electroZ-microsystems/SL5C/README.md

# SL5C

Spot light 5 colors DMX

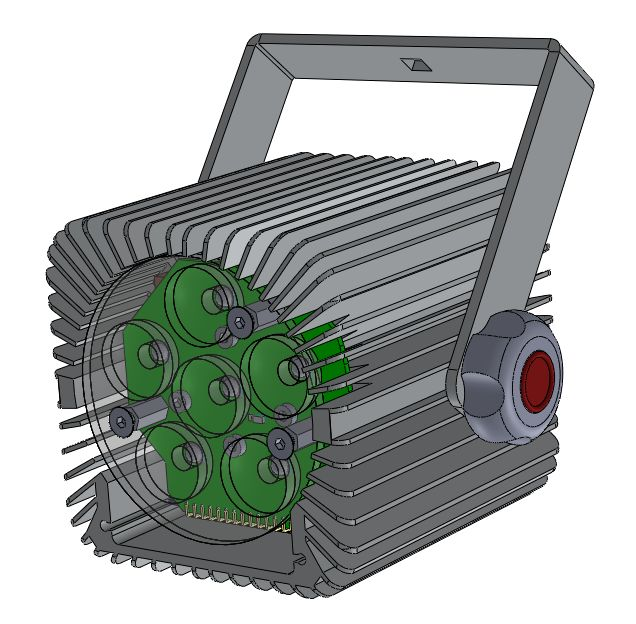
[picture p1: Image/20150911_225059_SL5CL_1.93_002..jpg]
[//]: 

<p align="center">
  SL5C
</p>

# Datasheet

Total Power 40W

Warm Wite Power 20W

Cold White Power 5W

Red Power 5W

Green Power 5W

Blue Power 5W

Voltage 24V

Number of power LEDs RGBcW 4, Warm White 2 from CREE

Crontrol DMX

# Controller 

Atmel Arduino Leonardo Chip, Arduino code
