electroZ-microsystems/SL5C/Image/20131019_220510_ProjecteurLedExtruded..jpg

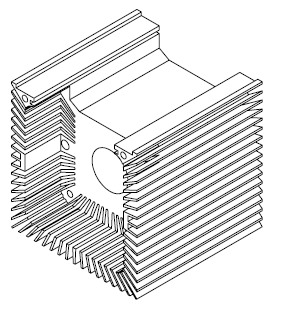
Image/20131019_220510_ProjecteurLedExtruded..jpg
