electroZ-microsystems/SL5C/Image/20140114_231739_Sim001..png

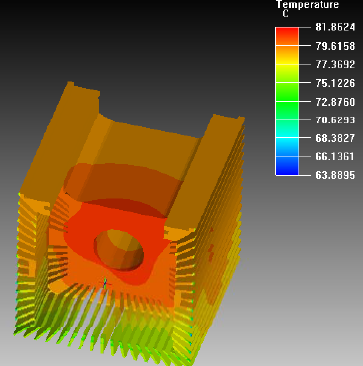
Image/20140114_231739_Sim001..png
