electroZ-microsystems/SL5C/Image/20140208_111850_XPC_Warm_Angle_med..jpg

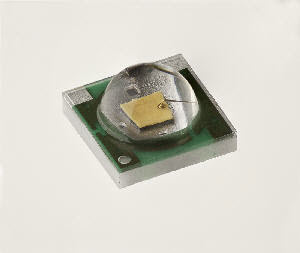
Image/20140208_111850_XPC_Warm_Angle_med..jpg
