electroZ-microsystems/SL5C/Image/20140208_112255_XPC_Warm_Angle_med..png

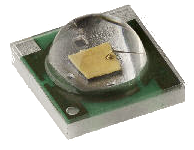
Image/20140208_112255_XPC_Warm_Angle_med..png
