electroZ-microsystems/SL5C/Image/20140509_221927_CoupeConnecteurSL5C_001..jpg

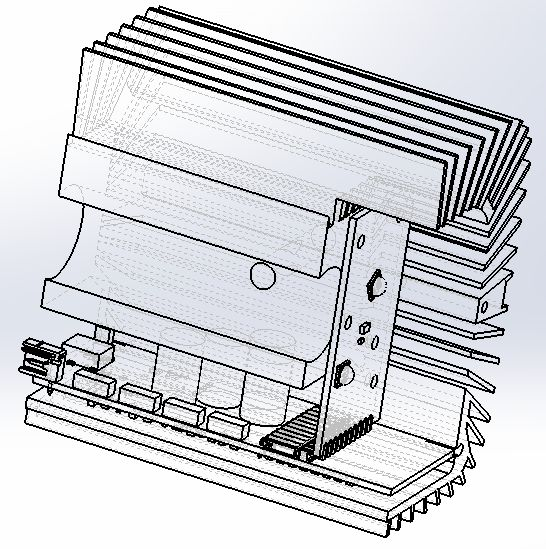
Image/20140509_221927_CoupeConnecteurSL5C_001..jpg
