electroZ-microsystems/SL5C/Image/20140509_222102_CoupeConnecteurSL5C_002..jpg

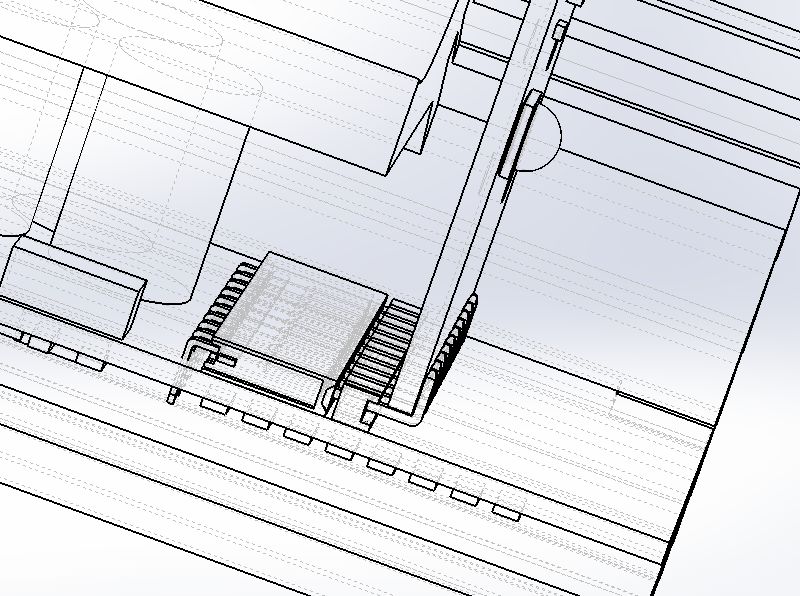
Image/20140509_222102_CoupeConnecteurSL5C_002..jpg
