electroZ-microsystems/SL5C/Image/20140916_155051_Rendu001..jpg

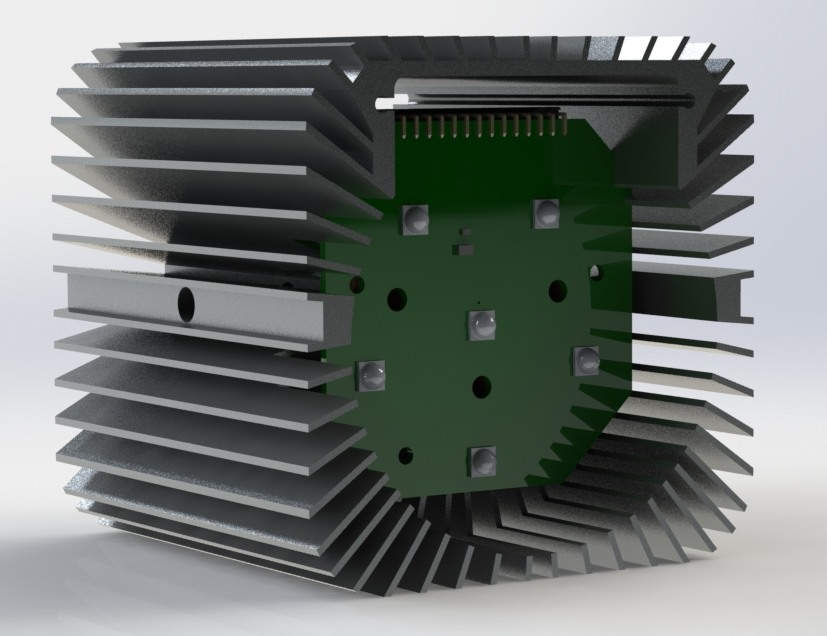
Image/20140916_155051_Rendu001..jpg
