electroZ-microsystems/SL5C/Image/20141115_224456_scan_090..jpg

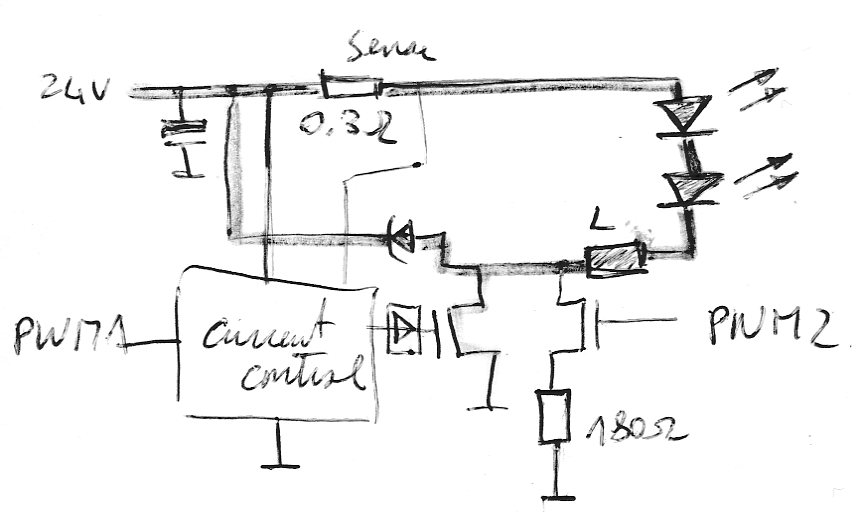
Image/20141115_224456_scan_090..jpg
