electroZ-microsystems/SL5C/Image/20150410_223701_HeatSink_1.8..jpg

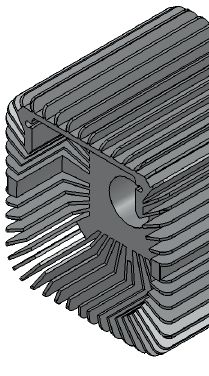
Image/20150410_223701_HeatSink_1.8..jpg
