electroZ-microsystems/SL5C/Image/20150420_132513_SpotLight_1.9_copper..jpg

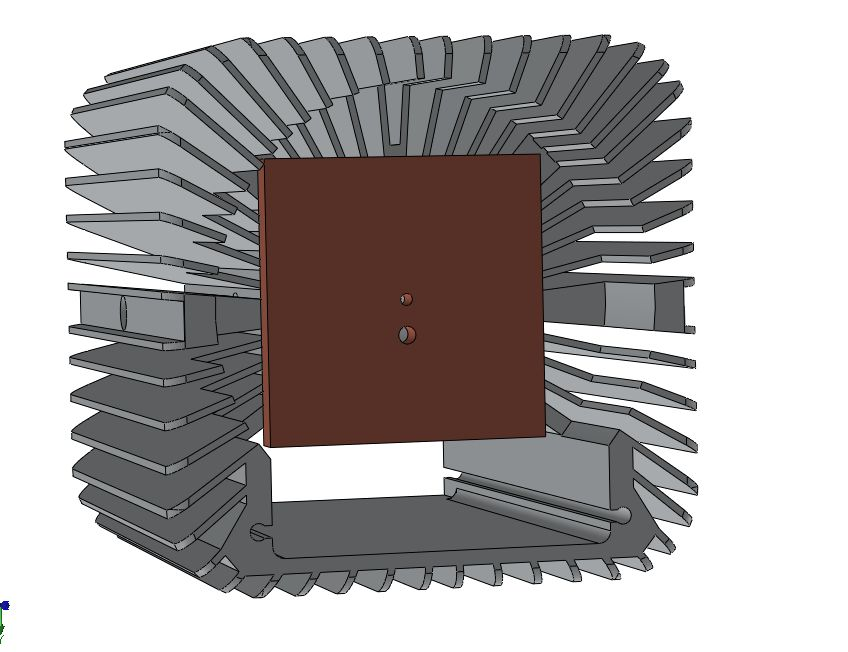
Image/20150420_132513_SpotLight_1.9_copper..jpg
