electroZ-microsystems/SL5C/Image/20150423_220920_Rendu001_version1.9..jpg

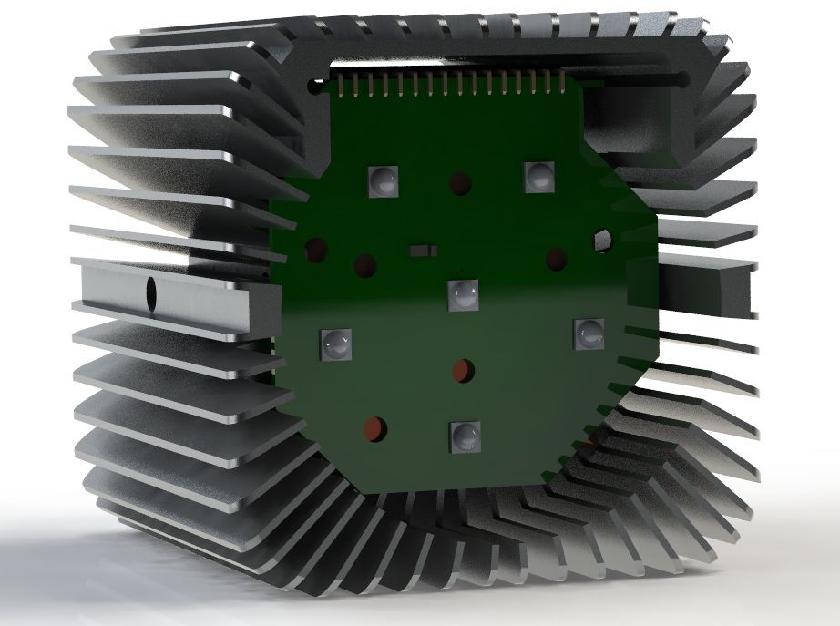
Image/20150423_220920_Rendu001_version1.9..jpg
