electroZ-microsystems/SL5C/Image/20150620_075052_HeatSink_1.92_hill_eclate..jpg

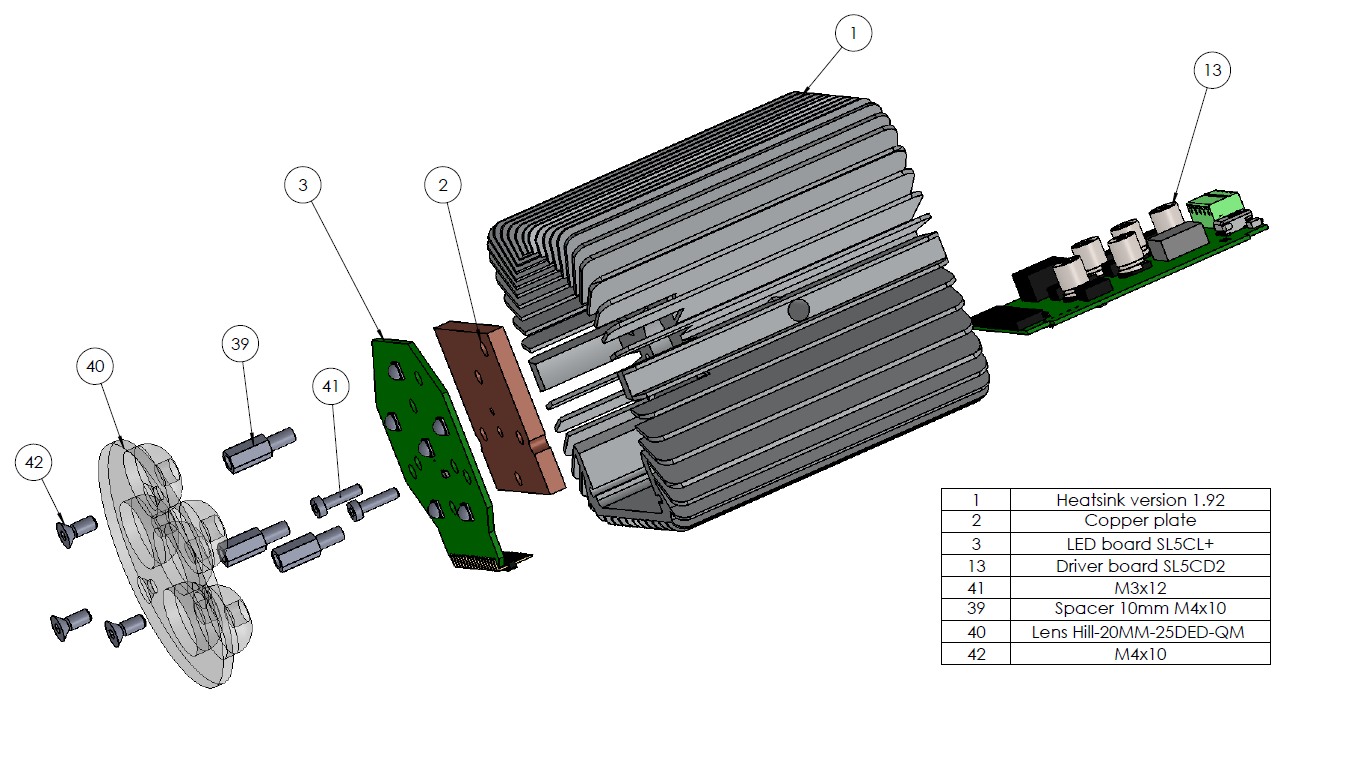
Image/20150620_075052_HeatSink_1.92_hill_eclate..jpg
