electroZ-microsystems/SL5C/Image/20150911_195431_SL5CL_1.93_001..jpg

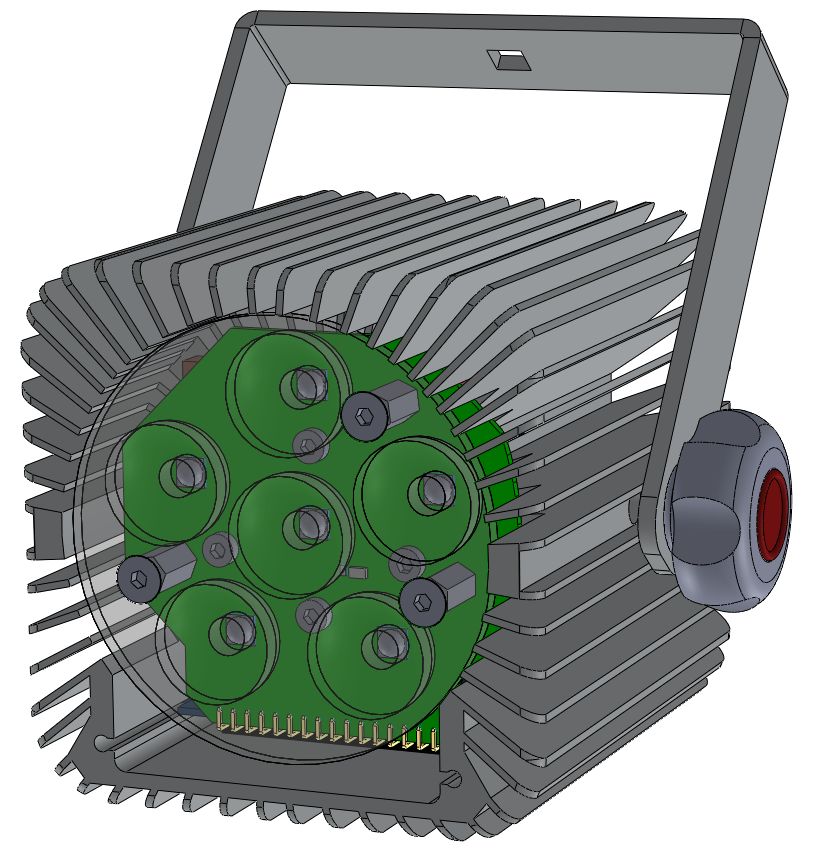
Image/20150911_195431_SL5CL_1.93_001..jpg
