electroZ-microsystems/SL5C/Image/20150911_225236_SL5CL_1.93_003..jpg

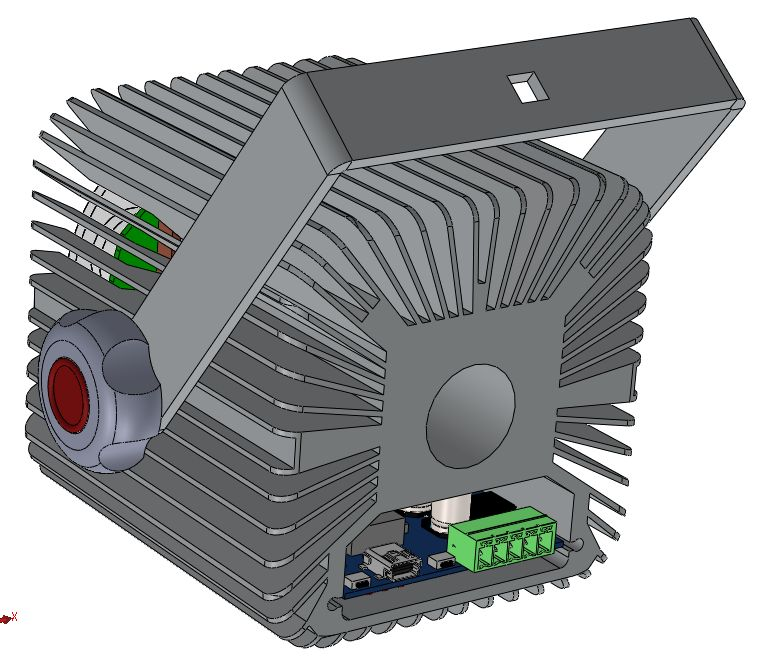
Image/20150911_225236_SL5CL_1.93_003..jpg
