electroZ-microsystems/SL5C/Image/20150911_225351_SL5CL_1.93_004..jpg

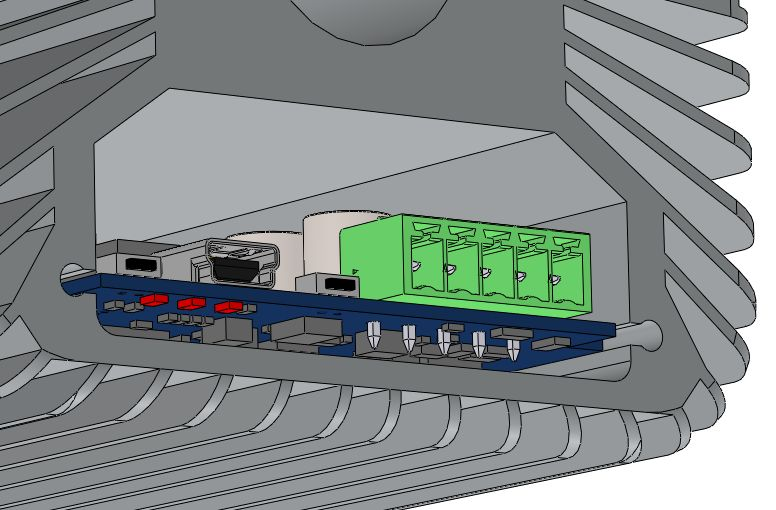
Image/20150911_225351_SL5CL_1.93_004..jpg
