electroZ-microsystems/SL5C/Image/20150924_202119_SL5CL_1.93_005..jpg

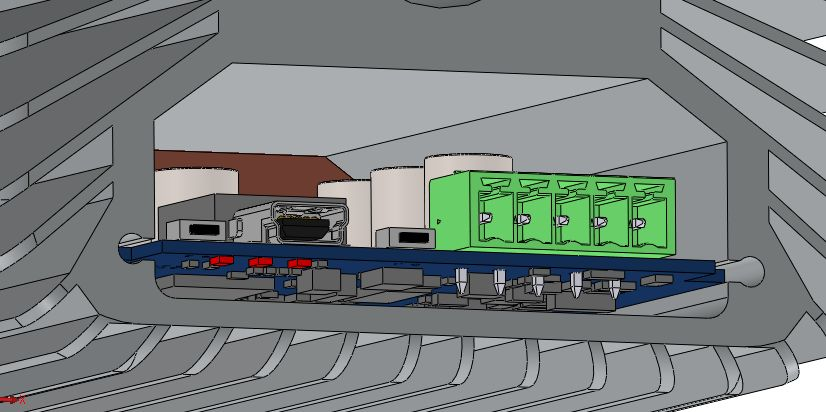
Image/20150924_202119_SL5CL_1.93_005..jpg
