electroZ-microsystems/SL5C/Image/20160526_214417_cable..jpg

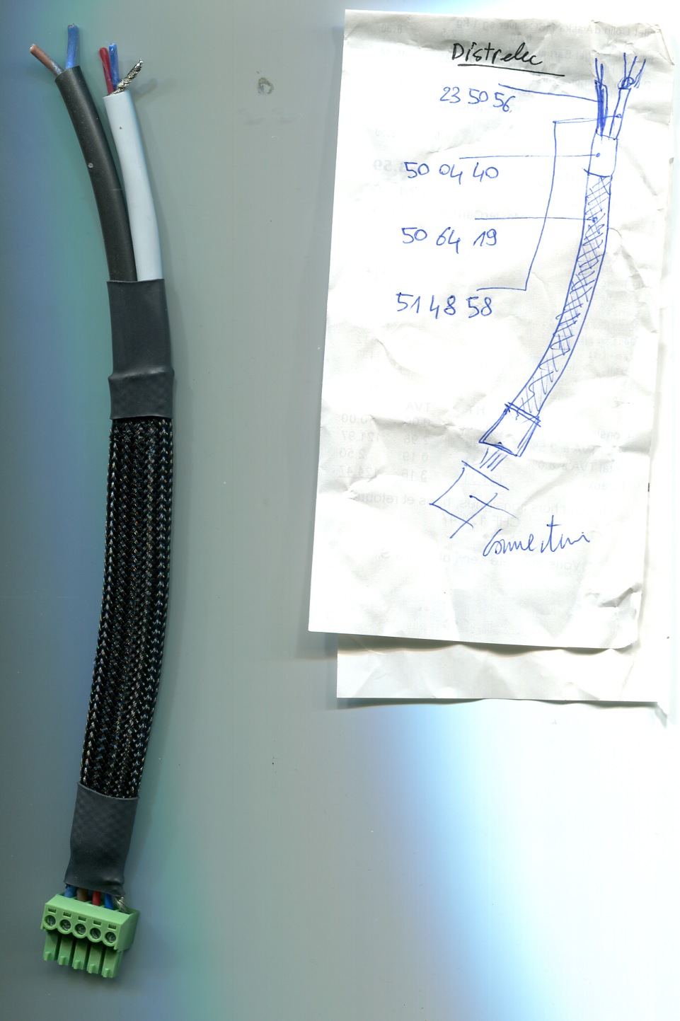
Image/20160526_214417_cable..jpg
