electroZ-microsystems/SL5C/PDF/Drawing_HeatSinkAndCopperPlate.pdf

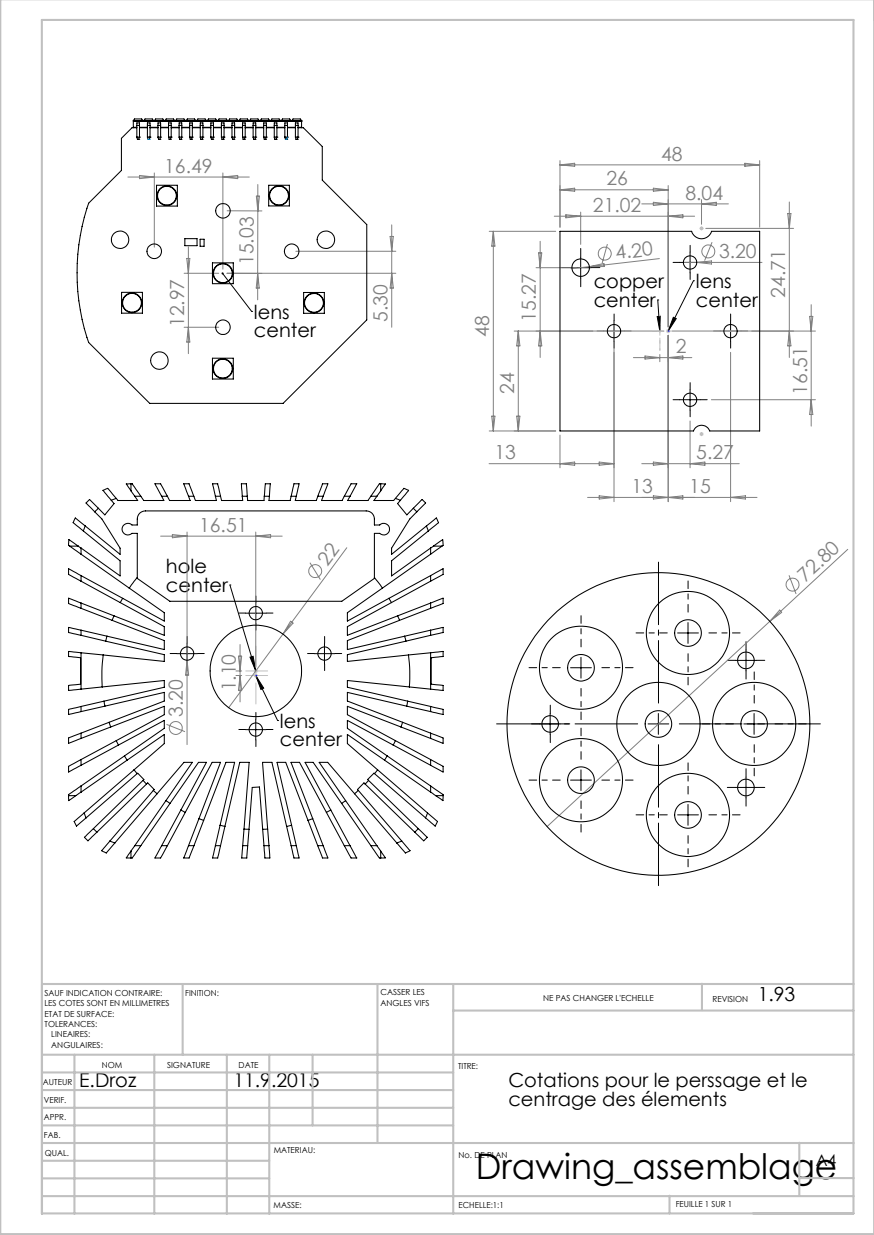
[picture p22: page 1]
center 12.97; ECHELLE:1:1; FEUILLE 1 SUR 1; NE PAS CHANGER L'ECHELLE; REVISION; CASSER LES ANGLES VIFS; SAUF INDICATION CONTRAIRE:; FINITION:

LES COTES SONT EN MILLIMETRES
ETAT DE SURFACE:
TOLERANCES:
LINEAIRES:
ANGULAIRES:

NOM | SIGNATURE | DATE | | | | TITRE: Cotations pour le perssage et le centrage des élements
AUTEUR | E.Droz | | 11.9.2015
QUAL. | | | | MATERIAU: | Drawing_assemblage MASSE: No. DE PLAN | A4

VERIF.
APPR.
FAB.
