electroZ-microsystems/SL5C/Arduino/PWM_color_fine.h

const unsigned int cPWMTable_fine[]   = {0,
1,
2,
3,
4,
5,
6,
7,
8,
9,
10,
10,
11,
11,
12,
13,
13,
14,
15,
15,
16,
17,
18,
18,
19,
20,
21,
22,
23,
25,
26,
27,
28,
30,
31,
32,
34,
36,
37,
39,
41,
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
