electroZ-microsystems/SL5C/Arduino/PWM_fine.h

const unsigned int PWMTable_fine[]   = {0,
5,
7,
10,
12,
13,
14,
15,
16,
17,
18,
19,
20,
21,
22,
23,
25,
26,
28,
30,
31,
33,
35,
37,
39,
42,
44,
47,
50,
52,
56,
59,
62,
66,
70,
74,
78,
83,
88,
93,
98,
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
