electroZ-microsystems/SL5C/(commit log)

2018-11-24 Added schematic
2018-11-28 Added manual/schematics pdf
